camura-io/Balanced-Rolling-Ball-Car/BalancingJoystick/CODE_EXPLANATION.md

# H750 单步进滚球控制工程说明

生成日期：2026-07-31  
目标工程：`H750_single_stepper_board`  
主控芯片：STM32H750VBT6  
开发环境：STM32CubeMX + Keil MDK-ARM

## 1. 工程目标

本工程用于车载平衡滚球运动控制系统的单轴摆杆/水管控制。系统通过步进电机改变水管倾角，使钢球在水管轴向移动或稳定在目标位置附近。当前工程保留了赛题第三问的独立控制逻辑，并加入了 MS901M 姿态/加速度数据，用于稳定和前馈补偿。

系统核心思路是：

- K230 摄像头识别钢球位置，并通过串口发送球相对中心的毫米值。
- STM32H750 接收视觉位置，计算球的位置误差和速度。
- MS901M 通过串口输出姿态角和加速度，提供水管姿态反馈与小车加速度前馈。
- STM32 输出 STEP/DIR 脉冲控制张大头步进电机，串口命令保留用于驱动器使能、失能、回零等动作。
- OLED 显示当前通信、零点、误差、前馈和运行状态。

## 2. 主要硬件接口

| 模块 | STM32 外设/引脚 | 用途 |
| --- | --- | --- |
| 步进电机 STEP | PB4 / TIM3_CH1 / GPIO | 输出步进脉冲 |
| 步进电机 DIR | PE0 | 控制电机方向 |
| 步进电机 EN | PB8 | 使能/释放驱动器 |
| 步进驱动串口 | USART3，115200 | 发送使能、失能、回零命令 |
| MS901M | USART1，115200 | 接收姿态角和加速度 |
| K230 | USART2，115200 | 接收钢球位置数据 |
| OLED | I2C | 显示状态和调试数据 |
| 运行 LED | PA1 | 1 秒闪烁或状态提示 |
| 当前调试 K1 | PE3 | 回零后启动稳定 |
| 当前调试 K2 | PC5 | 临时回零/保留赛题第三问入口 |
| PCB 预留按键 | PE7、PE9、PE11、PE13 | 后续板上按键 K1-K4 |

说明：当前代码中运行按键仍使用核心板调试接线 PE3、PC5；PCB 版 PE7/PE9/PE11/PE13 已在工程中保留。

## 3. 时钟与节拍

系统时钟使用 25 MHz 外部晶振，通过 PLL 配置到 480 MHz。TIM6 作为 1 ms 系统节拍，采用“计次分频”方式在定时中断/周期任务中执行控制逻辑：

- 1 ms：按键扫描、步进电机脉冲推进、LED 计时。
- 20 ms：视觉/稳定控制环计算。
- 200 ms：OLED 刷新。
- 1000 ms：正常运行 LED 翻转。

这种结构减少了 `while` 中的复杂逻辑，使控制时序更稳定。

## 4. 软件结构

主要文件如下：

| 文件 | 作用 |
| --- | --- |
| `Src/main.c` | 主状态机、按键逻辑、步进控制、K230 解析、球控制 PID/分段控制、MS901M 稳定与前馈 |
| `Inc/imu901.h`、`Src/imu901.c` | MS901M 串口协议解析，支持姿态角帧和加速度帧 |
| `Inc/oled.h`、`Src/oled.c` | OLED 显示驱动 |
| `Src/usart.c` | USART1/USART2/USART3 初始化 |
| `Src/tim.c` | TIM3、TIM6 初始化 |
| `Src/gpio.c` | LED、按键、步进引脚初始化 |
| `H750_single_stepper_board.ioc` | CubeMX 外设配置 |

## 5. MS901M 通信

MS901M 使用 USART1，波特率 115200。驱动解析格式为：

```text
55 55 ID LEN DATA SUM
```

当前支持两类数据帧：

- `ID = 0x01, LEN = 6`：欧拉角 roll、pitch、yaw。
- `ID = 0x03, LEN = 12`：加速度 XYZ + 角速度 XYZ。

初始化时向 MS901M 发送配置命令，使其输出姿态角与加速度/角速度，并设置 50 Hz 输出频率。主控主要使用：

- 姿态角：用于水管调平和角度稳定。
- 选定轴加速度：用于小车加速度前馈补偿。当前配置使用 MS901M 的 Y 轴加速度，因为水管轴向与 901 的 Y 轴平行。

## 6. 控制逻辑

### 6.1 开机状态

复位后电机默认失能，驱动器处于可以手动转动的状态。程序会通过 EN 引脚和串口失能命令释放电机，避免上电后机械结构突然动作。

### 6.2 K1 流程

按下 K1 后执行：

1. 使能电机。
2. 发送回零命令，使水管回到机械零点附近。
3. 等待回零完成。
4. 采集 MS901M 当前姿态角作为角度零点。
5. 采集 MS901M 当前轴向加速度作为加速度零点。
6. 进入中心稳定模式。

### 6.3 位置闭环

K230 发送球位置后，STM32 得到球相对中心的毫米误差。控制中使用位置误差、速度估计、预测误差和限幅逻辑，生成电机目标倾角。目标是让钢球尽量不离开中心 1 cm 范围。

### 6.4 加速度前馈

当前版本不再使用 ICM42688。前馈改为使用 MS901M 加速度：

```text
前馈倾角约等于 轴向加速度 / 重力加速度
```

代码中先减去 K1 清零时记录的加速度零点，再换算成步进电机目标步数。这样当小车前后加速时，水管可以提前倾斜，用来抵消钢球受到的惯性影响。

### 6.5 软件限位

电机目标角受到软件限位保护，当前测试限位为正负 20 度。所有视觉闭环、姿态稳定和前馈补偿最终都会经过统一限幅，避免机械结构过度倾斜。

## 7. OLED 状态含义

常见显示内容：

| 显示 | 含义 |
| --- | --- |
| `MS901 ANG WAIT` | 没有收到新的 MS901M 姿态角帧 |
| `MS901 ACC WAIT` | 没有收到新的 MS901M 加速度帧 |
| `ZERO xx/50` | 正在采集零点 |
| `RUN Pxxxxx` | 稳定模式运行中，显示当前电机位置 |
| `Mxxxxx Axxxx` | `M` 为加速度误差 mg，`A` 为前馈输出步数 |
| `MS901 RX OK` | MS901M 角度和加速度通信正常 |

## 8. K230 数据格式

K230 通过 USART2 发送一行文本数据。STM32 从中解析目标中心、框大小和标定后的毫米位置，核心控制量是球相对水管中心的 `pos_mm`。视觉标定中，水管中心为 0 mm，左右黑点间距对应 5 cm，用于把像素坐标换算成厘米/毫米位置。

## 9. 当前编译结果

本次打包前已使用 Keil 后台编译：

```text
0 Error(s), 0 Warning(s)
```

编译日志文件：`MDK-ARM/build_package_report.log`  
当前 hex 文件：`MDK-ARM/H750_single_stepper_board/H750_single_stepper_board.hex`

## 10. 后续可继续完善的方向

- 将运行按键从当前调试用 PE3/PC5 切换到 PCB 版 PE7/PE9/PE11/PE13。
- 根据实测结果微调 MS901M 加速度前馈方向 `ACC_FF_SIGN`。
- 将赛题第三问的独立程序重新分配到指定按键。
- 继续优化中心稳定 PID，使钢球在小车加减速时保持在 1 cm 范围内。
