camura-io/Balanced-Rolling-Ball-Car/LineTracking/build_log.txt

*** Using Compiler 'V5.06 update 5 (build 528)', folder: 'D:\keil\ARM\ARMCC\Bin'
Build target 'Target 1'
compiling App_Mode.c...
.\System\Timer1.h(65): warning:  #1-D: last line of file ends without a newline
  						   
Hardware\App_Mode.c: 1 warning, 0 errors
linking...
Program Size: Code=13218 RO-data=1798 RW-data=136 ZI-data=1632  
".\Objects\Project.axf" - 0 Error(s), 1 Warning(s).
Build Time Elapsed:  00:00:01
