camura-io/Balanced-Rolling-Ball-Car/BalancingJoystick/Inc/main.h

#define KEY_K5_Pin GPIO_PIN_3
#define KEY_K5_GPIO_Port GPIOE
#define ICM42688_CS_Pin GPIO_PIN_4
#define ICM42688_CS_GPIO_Port GPIOE
#define ICM42688_INT1_Pin GPIO_PIN_5
#define ICM42688_INT1_GPIO_Port GPIOE
#define RUN_LED_Pin GPIO_PIN_1
#define RUN_LED_GPIO_Port GPIOA
#define KEY_K6_Pin GPIO_PIN_5
#define KEY_K6_GPIO_Port GPIOC
#define KEY_K1_Pin GPIO_PIN_7
#define KEY_K1_GPIO_Port GPIOE
#define KEY_K2_Pin GPIO_PIN_9
#define KEY_K2_GPIO_Port GPIOE
#define KEY_K3_Pin GPIO_PIN_11
#define KEY_K3_GPIO_Port GPIOE
#define KEY_K4_Pin GPIO_PIN_13
#define KEY_K4_GPIO_Port GPIOE
#define X_EN_Pin GPIO_PIN_8
#define X_EN_GPIO_Port GPIOB
#define X_DIR_Pin GPIO_PIN_0
#define X_DIR_GPIO_Port GPIOE
