camura-io/Balanced-Rolling-Ball-Car/(notices)

Notices in the files:
BalancingJoystick/Src/main.c:
Copyright (c) 2026 STMicroelectronics.
All rights reserved.
This software is licensed under terms that can be found in the LICENSE file
